rfidio/lpc1347_refboard/images/finished.jpg

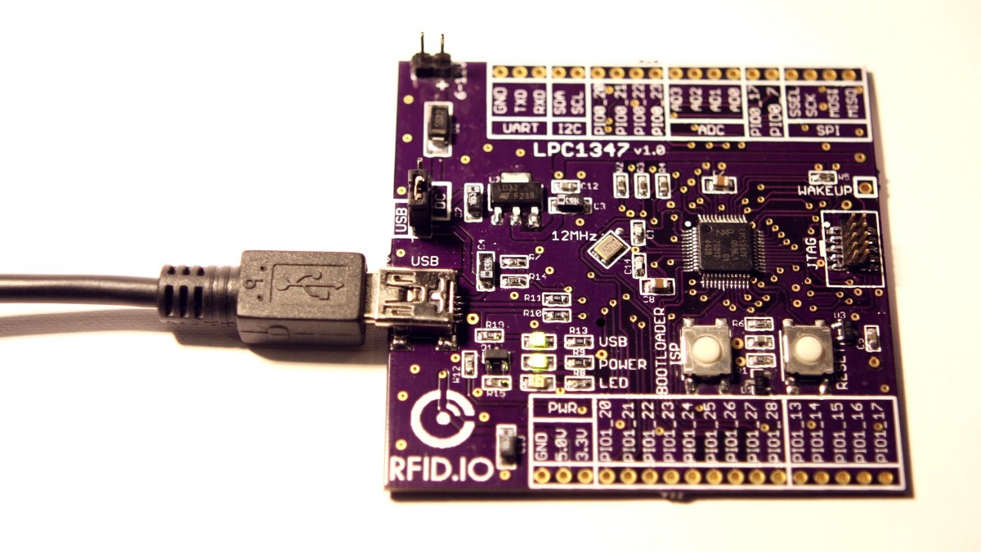
images/finished.jpg
