rfidio/lpc1347_refboard/README.md

LPC1347 reference board
=======================

This reference design is based on LPC1343 Reference Design produced by [microBuilder.eu](http://www.microbuilder.eu/Projects/LPC1343ReferenceDesign.aspx).

- - -

finished

- - -
