rfidio/lpc1347_refboard/images/pcb_bottom.png

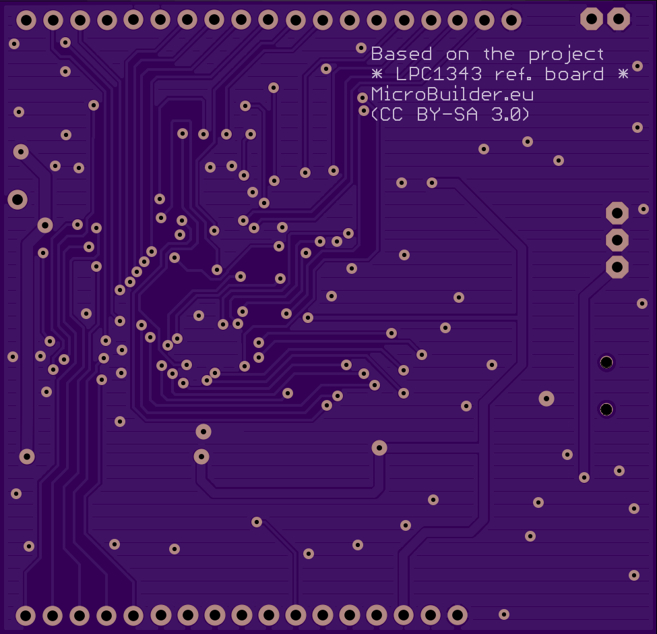
images/pcb_bottom.png
