rfidio/lpc1347_refboard/images/pcb_top.png

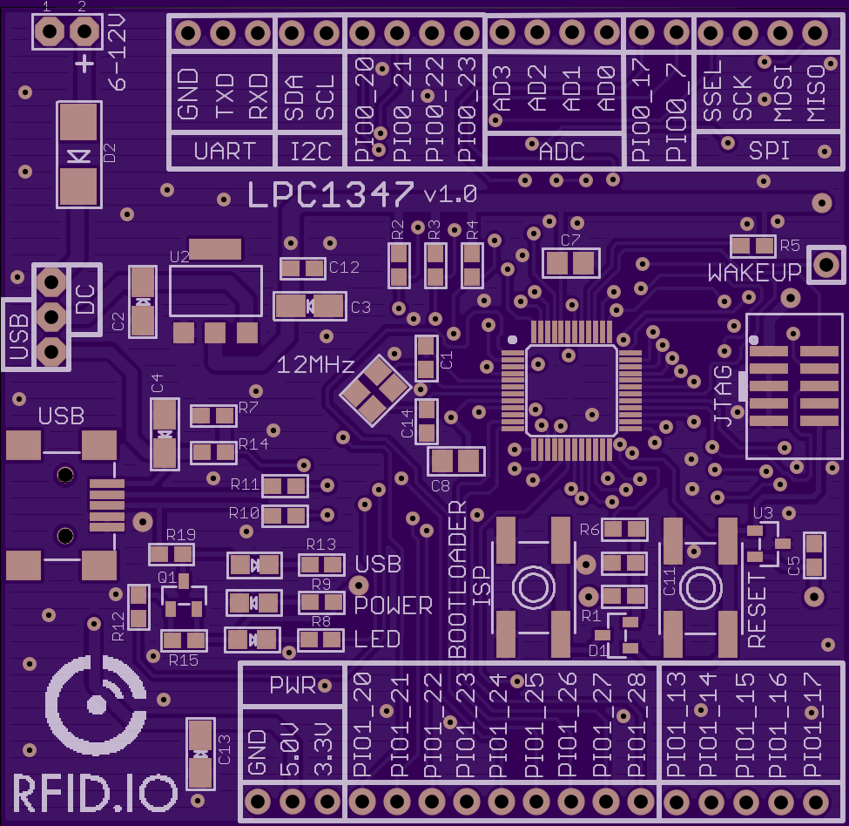
images/pcb_top.png
