rfidio/lpc1347_refboard/lpc1347_refboard.brd

## EAGLE design lpc1347_refboard.brd (2013-07-09)

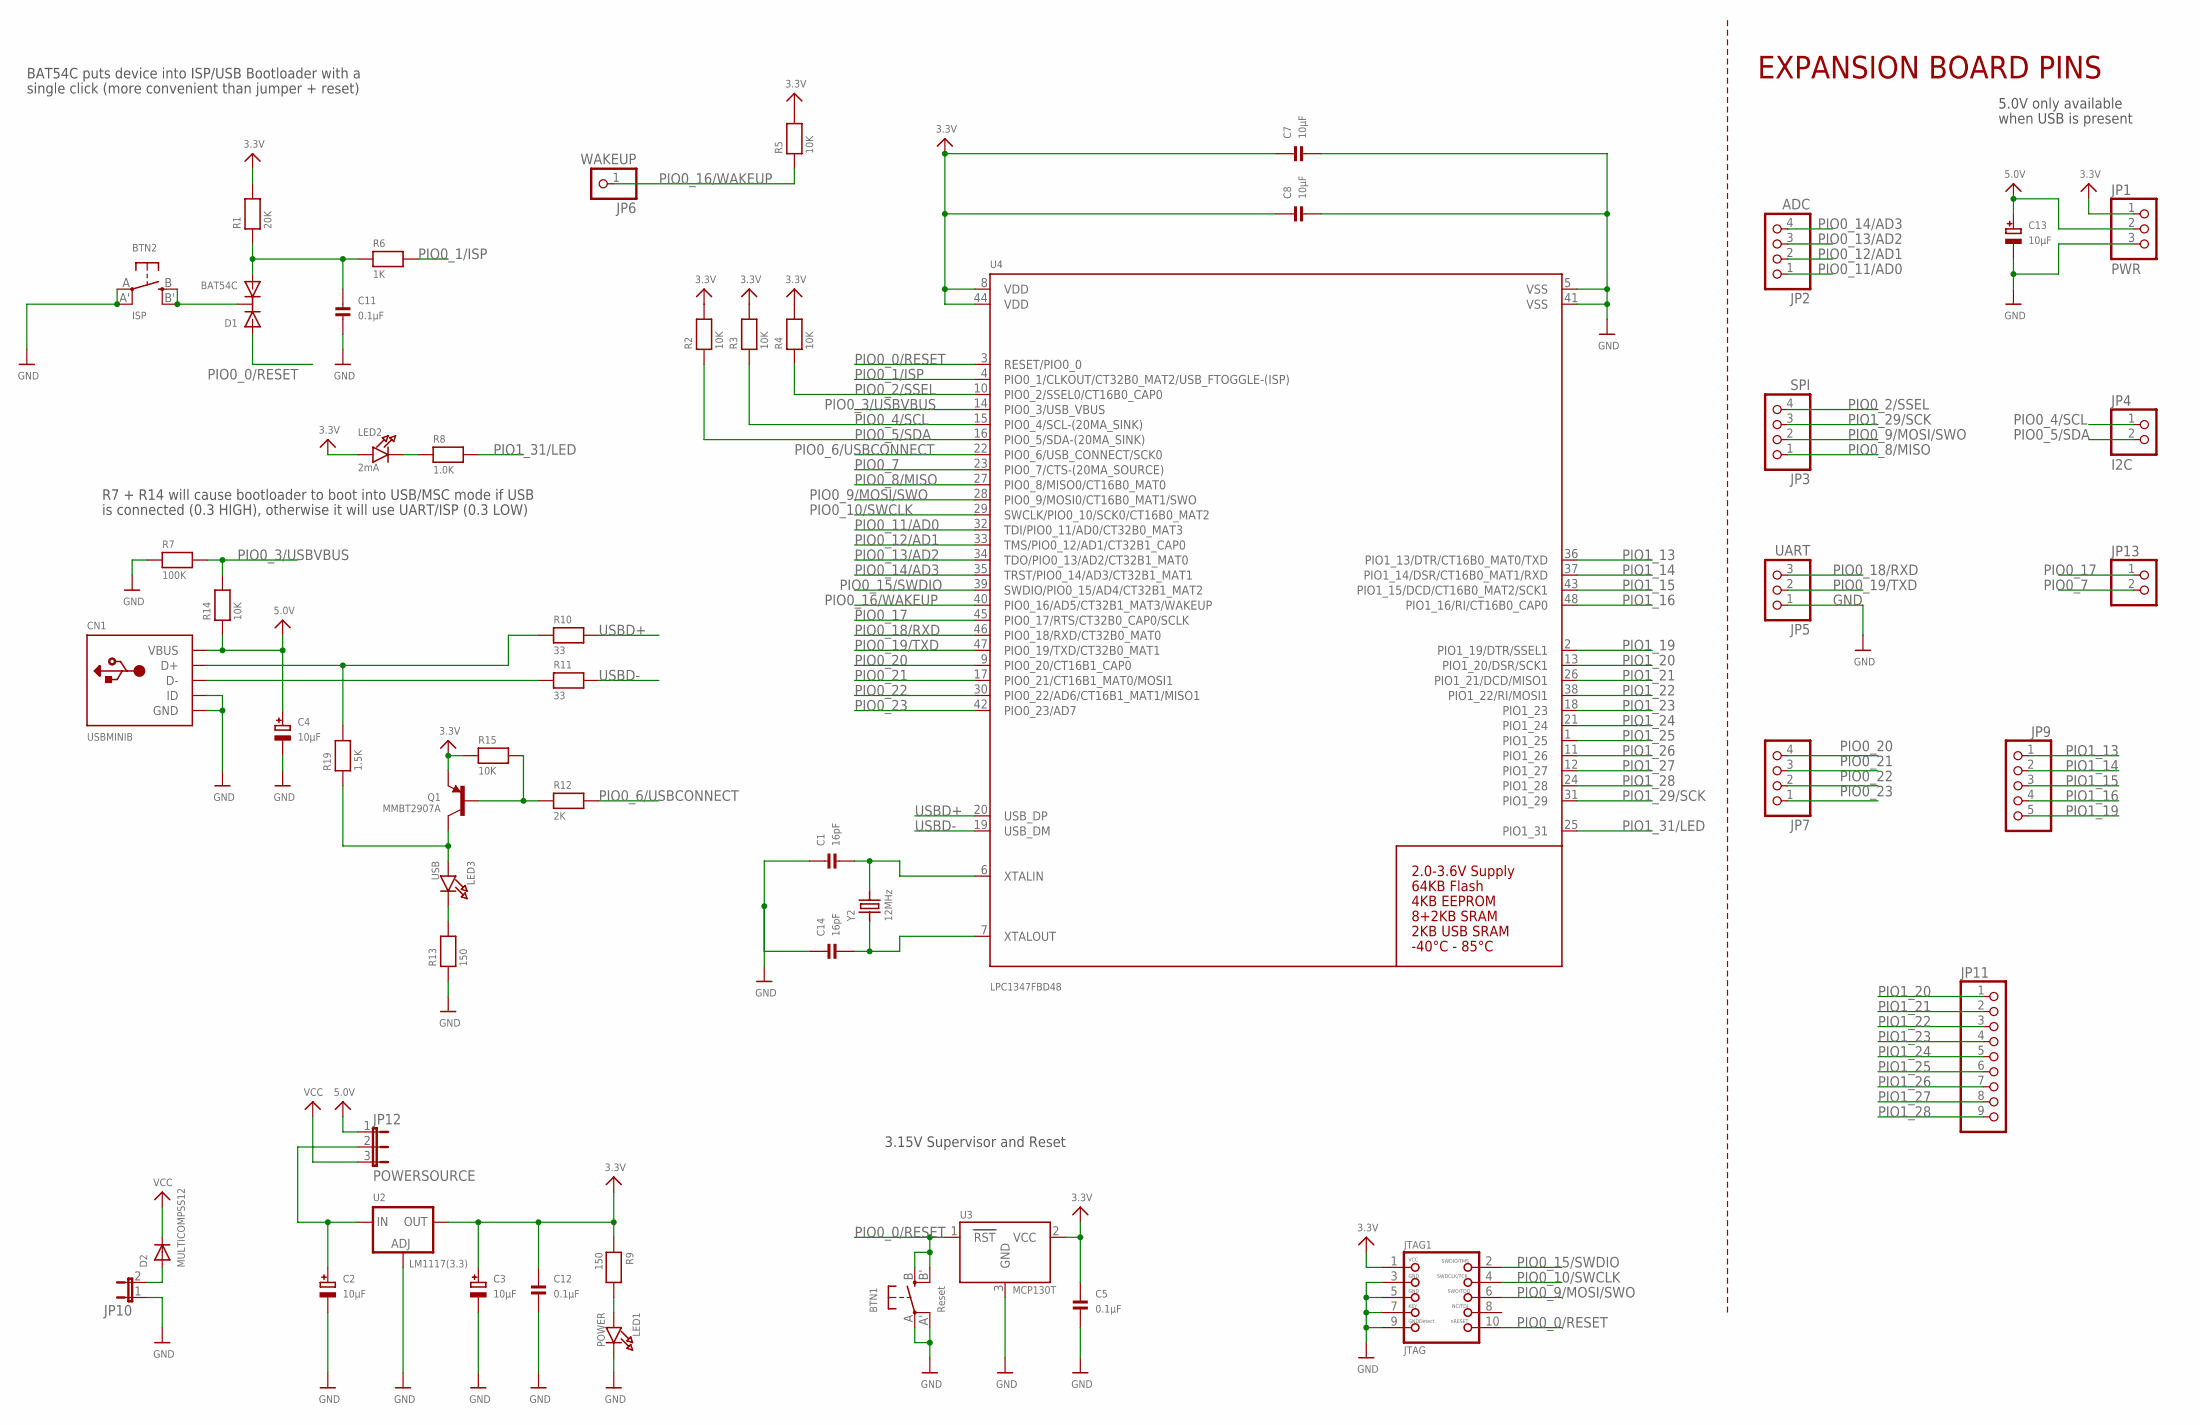
[picture p4: schematic lpc1347_refboard.sch]

Parts:
BTN1: Reset; EVQ-Q2
BTN2: ISP; EVQ-Q2
C1, C14: 16pF; 0603
C2, C3, C4, C13: 10µF; EIA3216-18/A-R
C5, C11, C12: 0.1µF; 0603
C7, C8: 10µF; 0805
CN1: USBMINIB; USB-MINIB
D1: BAT54C; SOT23-R
D2: MULTICOMPSS12; SMADIODE
JP1: PWR; 1X03_ROUND
JP2: ADC; 1X04_ROUND
JP3: SPI; 1X04_ROUND
JP4: I2C; 1X02_ROUND
JP5: UART; 1X03_ROUND
JP6: WAKEUP; 1X01_ROUND
JP7: HEADER-1X4ROUND; 1X04_ROUND
JP9: HEADER-1X5ROUND; 1X05_ROUND
JP10: JUMPER2
JP11: HEADER-1X970MIL; 1X09_ROUND_70
JP12: POWERSOURCE; JUMPER3
JP13: HEADER-1X2ROUND; 1X02_ROUND
JTAG1: JTAG; 2X05_1.27MM_SMT
LED1: POWER; CHIPLED_0805
LED2: 2mA; CHIPLED_0805
LED3: USB; CHIPLED_0805
Q1: MMBT2907A; SOT23-R
R1: 20K; 0603
R2, R3, R4, R5, R14, R15: 10K; 0603
R6: 1K; 0603
R7: 100K; 0603
R8: 1.0K; 0603
R9, R13: 150; 0603
R10, R11: 33; 0603
R12: 2K; 0603
R19: 1.5K; 0603
U2: LM1117(3.3); SOT223-R
U3: MCP130T; SOT23-R
U4: LPC1347FBD48; LQFP48
Y2: 12MHz; CRYSTAL_3.2X2.5

Connections:
3.3V: C3.+, C5.1, C7.1, C8.1, C12.1, JP1.1, JTAG1.1, LED2.A, Q1.2 (E), R1.2, R2.2, R3.2, R4.2, R5.2, R9.1, R15.1, U2.2 (OUT), U3.2 (VCC), U4.8 (VDD), U4.44 (VDD)
5.0V: C4.+, C13.+, CN1.VBUS, JP1.2, JP12.1, R14.1
GND: BTN1.A, BTN1.A' (P1), BTN2.A, BTN2.A' (P1), C1.1, C2.-, C3.-, C4.-, C5.2, C7.2, C8.2, C11.2, C12.2, C13.-, C14.1, CN1.GND, CN1.ID, JP1.3, JP5.1, JP10.1, JTAG1.3, JTAG1.5, JTAG1.7, JTAG1.9, LED1.C, R7.1, R13.1, U2.1 (ADJ), U3.3 (GND), U4.5 (VSS), U4.41 (VSS)
unnamed: LED2.C, R8.1
unnamed: C2.+, JP12.2, U2.3 (IN)
unnamed: D2.A, JP10.2
unnamed: BTN2.B (S), BTN2.B' (S1), D1.3 (C)
unnamed: CN1.D+, R10.1, R19.2
unnamed: Q1.1 (B), R12.1, R15.2
unnamed: C11.1, D1.2 (A2), R1.1, R6.1
unnamed: LED1.A, R9.2
unnamed: LED3.C, R13.2
unnamed: CN1.D-, R11.1
unnamed: LED3.A, Q1.3 (C), R19.1
PIO0_0/RESET: BTN1.B (S), BTN1.B' (S1), D1.1 (A1), JTAG1.10, U3.1 (RST), U4.3 (RESET/PIO0_0)
PIO0_1/ISP: R6.2, U4.4 (PIO0_1/CLKOUT/CT32B0_MAT2/USB_FTOGGLE-(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)
PIO0_2/SSEL: JP3.4, R4.1, U4.10 (PIO0_2/SSEL0/CT16B0_CAP0)
PIO0_3/USBVBUS: R7.2, R14.2, U4.14 (PIO0_3/USB_VBUS)
PIO0_4/SCL: JP4.1, R3.1, U4.15 (PIO0_4/SCL-(20MA_SINK))
PIO0_5/SDA: JP4.2, R2.1, U4.16 (PIO0_5/SDA-(20MA_SINK))
PIO0_6/USBCONNECT: R12.2, U4.22 (PIO0_6/USB_CONNECT/SCK0)
PIO0_7: JP13.2, U4.23 (PIO0_7/CTS-(20MA_SOURCE))
PIO0_8/MISO: JP3.1, U4.27 (PIO0_8/MISO0/CT16B0_MAT0)
PIO0_9/MOSI/SWO: JP3.2, JTAG1.6, U4.28 (PIO0_9/MOSI0/CT16B0_MAT1/SWO)
PIO0_10/SWCLK: JTAG1.4, U4.29 (SWCLK/PIO0_10/SCK0/CT16B0_MAT2)
PIO0_11/AD0: JP2.1, U4.32 (TDI/PIO0_11/AD0/CT32B0_MAT3)
PIO0_12/AD1: JP2.2, U4.33 (TMS/PIO0_12/AD1/CT32B1_CAP0)
PIO0_13/AD2: JP2.3, U4.34 (TDO/PIO0_13/AD2/CT32B1_MAT0)
PIO0_14/AD3: JP2.4, U4.35 (TRST/PIO0_14/AD3/CT32B1_MAT1)
PIO0_15/SWDIO: JTAG1.2, U4.39 (SWDIO/PIO0_15/AD4/CT32B1_MAT2)
PIO0_16/WAKEUP: JP6.1, R5.1, U4.40 (PIO0_16/AD5/CT32B1_MAT3/WAKEUP)
PIO0_17: JP13.1, U4.45 (PIO0_17/RTS/CT32B0_CAP0/SCLK)
PIO0_18/RXD: JP5.3, U4.46 (PIO0_18/RXD/CT32B0_MAT0)
PIO0_19/TXD: JP5.2, U4.47 (PIO0_19/TXD/CT32B0_MAT1)
PIO0_20: JP7.4, U4.9 (PIO0_20/CT16B1_CAP0)
PIO0_21: JP7.3, U4.17 (PIO0_21/CT16B1_MAT0/MOSI1)
PIO0_22: JP7.2, U4.30 (PIO0_22/AD6/CT16B1_MAT1/MISO1)
PIO0_23: JP7.1, U4.42 (PIO0_23/AD7)
PIO1_13: JP9.1, U4.36 (PIO1_13/DTR/CT16B0_MAT0/TXD)
PIO1_14: JP9.2, U4.37 (PIO1_14/DSR/CT16B0_MAT1/RXD)
PIO1_15: JP9.3, U4.43 (PIO1_15/DCD/CT16B0_MAT2/SCK1)
PIO1_16: JP9.4, U4.48 (PIO1_16/RI/CT16B0_CAP0)
PIO1_19: JP9.5, U4.2 (PIO1_19/DTR/SSEL1)
PIO1_20: JP11.1, U4.13 (PIO1_20/DSR/SCK1)
PIO1_21: JP11.2, U4.26 (PIO1_21/DCD/MISO1)
PIO1_22: JP11.3, U4.38 (PIO1_22/RI/MOSI1)
PIO1_23: JP11.4, U4.18 (PIO1_23)
PIO1_24: JP11.5, U4.21 (PIO1_24)
PIO1_25: JP11.6, U4.1 (PIO1_25)
PIO1_26: JP11.7, U4.11 (PIO1_26)
PIO1_27: JP11.8, U4.12 (PIO1_27)
PIO1_28: JP11.9, U4.24 (PIO1_28)
PIO1_29/SCK: JP3.3, U4.31 (PIO1_29)
PIO1_31/LED: R8.2, U4.25 (PIO1_31)
USBD+: R10.2, U4.20 (USB_DP)
USBD-: R11.2, U4.19 (USB_DM)
VCC: D2.C, JP12.3
XTALIN: C1.2, U4.6 (XTALIN), Y2.2
XTALOUT: C14.2, U4.7 (XTALOUT), Y2.1

Notes on the sheet:
3.15V Supervisor and Reset
5.0V only available
when USB is present
EXPANSION BOARD PINS
R7 + R14 will cause bootloader to boot into USB/MSC mode if USB
is connected (0.3 HIGH), otherwise it will use UART/ISP (0.3 LOW)
BAT54C puts device into ISP/USB Bootloader with a
single click (more convenient than jumper + reset)

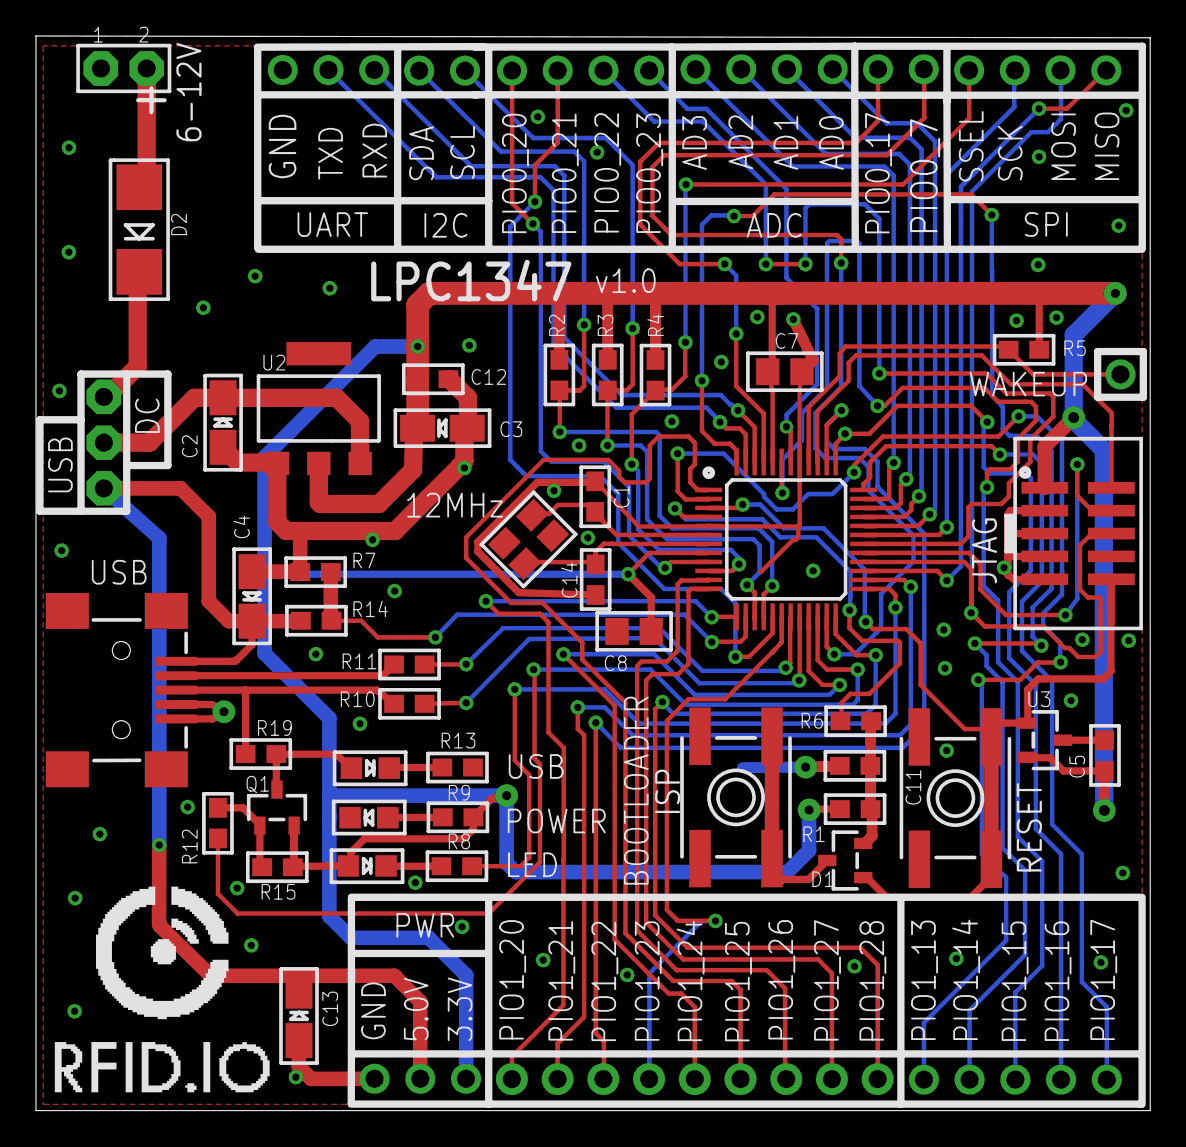
[picture p5: board lpc1347_refboard.brd from above]

Board: 2 copper layers, 61.9 x 59.7 mm, 54 parts (0 on the bottom side), 59 nets.

Other parts of the board:
U$23: RFID_IO_LOGO_1X1
